antho4572/projet_SI/README.md

Ce projet a été réalisé dans le cadre du projet de terminal S-SI.
Il concerne un distributeur de nourriture  autonome pour animaux domestiques.(dossier pdf pour plus d'informations)
Retrouvez les différents modules Arduino achetés ainsi que le cablage dans le dossier "Ressources".
Vous pouvez télécharger les différentes librairies utilisées dans le programme Arduino. 

Pour toutes questions, je suis joignable par mail :
duportanthony@gmail.com
