antho4572/projet_SI/Dossier projet interdisciplinaire.pdf

## Sciences de l’ingénieur

# Projet

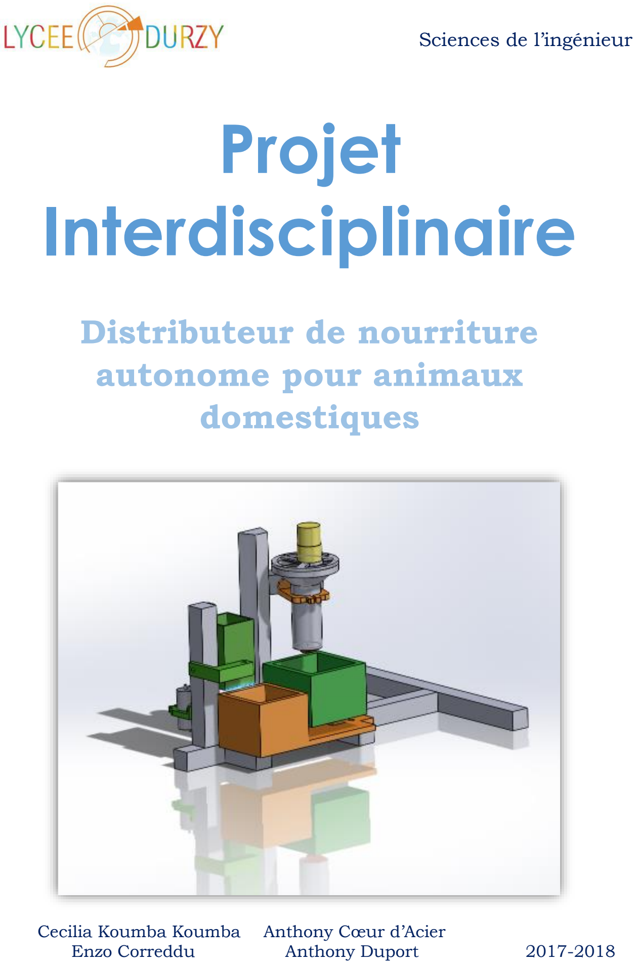
[picture p1: page 1]

Cecilia Koumba Koumba | Anthony Cœur d’Acier
Enzo Correddu | Anthony Duport | 2017-2018

# Interdisciplinaire

# Distributeur de nourriture autonome pour animaux domestiques

# Sommaire

C. PROBLEMATIQUE TECHNIQUE : COMMENT GERER AVEC PRECISION LES DOSES DE CROQUETTES ET LE VOLUME
E. DEFINITIONS DES HEURES ET DE LA PORTION DE CROQUETTES A DISTRIBUER SUIVANT LE POIDS ET LE TYPE DE

## I. Partie commune

A. Description du projet

Le contexte a été défini tel que lorsque le propriétaire de l’animal est absent, il faut nourrir l’animal dans n’importe quel endroit. De plus, il faut le nourrir à des heures définies avec des quantités de nourriture, solide et liquide, adaptées à l’animal et pouvoir communiquer avec l’appareil à distance.
Ainsi, il faudra une nourriture convenable pour un animal domestique, le chat par exemple, quand il est sans son maître durant la journée.
B. Analyse fonctionnelle
1. Expression du besoin

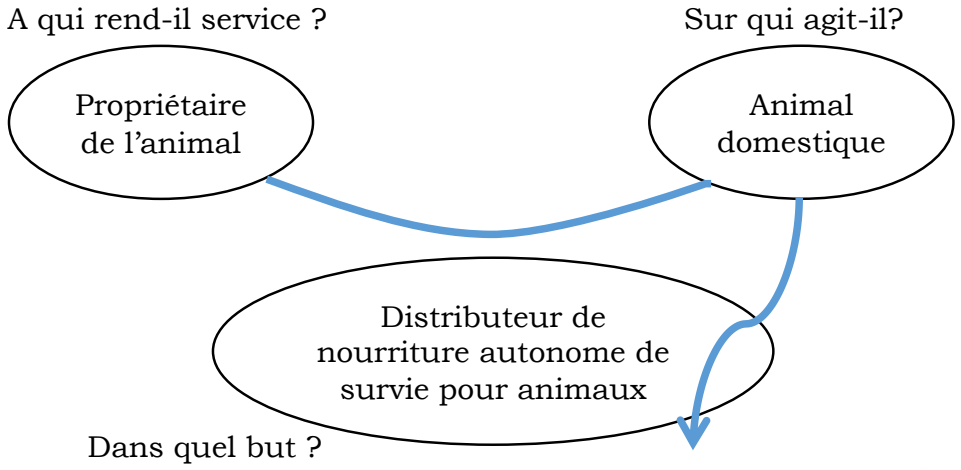
[picture p2: figure]
Propriétaire de l’animal; A qui rend-il service ?; Sur qui agit-il?; Animal domestique; Distributeur de nourriture autonome de survie pour animaux; Dans quel but ?

2. Actigramme de niveau A-0

Nourrir de façon autonome et automatisé un animal domestique

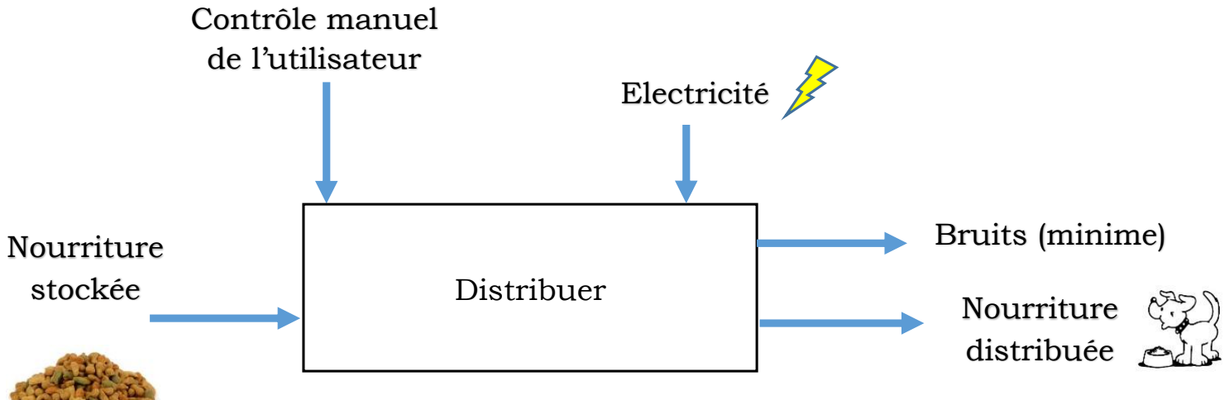
[picture p3: figure]
Contrôle manuel de l’utilisateur; Distribuer; Electricité; Nourriture distribuée; Bruits (minime) Nourriture; stockée

3. Diagramme des intéracteurs

FP1 : Distribuer l’eau et

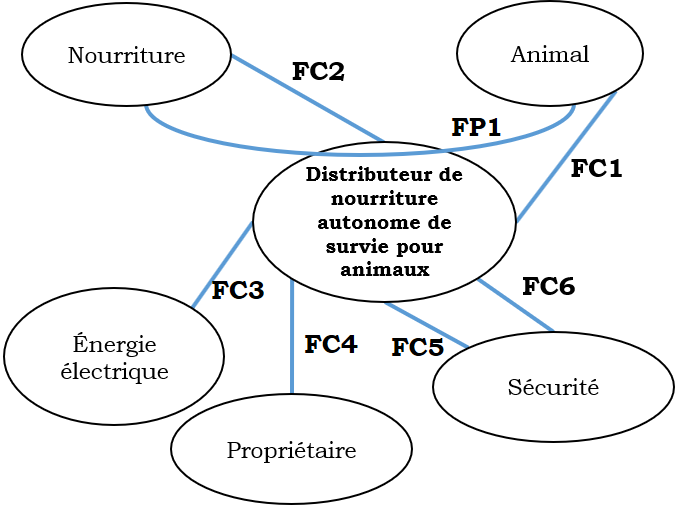
[picture p4: figure]

distribuer les croquettes à intervalles réguliers.
FC1 : S’adapter à tous types d’animaux.
FC2: Permettre un stockage suffisant de nourriture.
FC3: Avoir une autonomie
suffisante.
FC4: Etre facilement
transportable.
FC5: Permettre la sécurité de l’animal.
FC6: Etre au norme vis-à-vis de l’hygiène (croquettes).
4. Cahier des charges
- Pouvoir accepter différents types de croquettes pour animaux.
- Utiliser un récipient pour la nourriture liquide et solide et les stocker (Solide

2kg : Liquide 2L).

- Maintenir dans un réceptacle un niveau d’eau constant de

30 cl ± 3cl.

- Dose de croquette de 50 grammes par jour en trois

versements ±2g par versement.
- Être compatible avec le secteur comme source d’alimentation.
- Posséder plusieurs choix prédéfinis de réglage pour les

intervalles de nourriture.
- Être piloté par une carte électronique programmable.
- Un cycle de distribution devra durer maximum une minute.
- Durée de fonctionnement sans secteur : maximum 4 heures.
- L’ensemble devra peser maximum 10kg.
- Être facilement transportable.

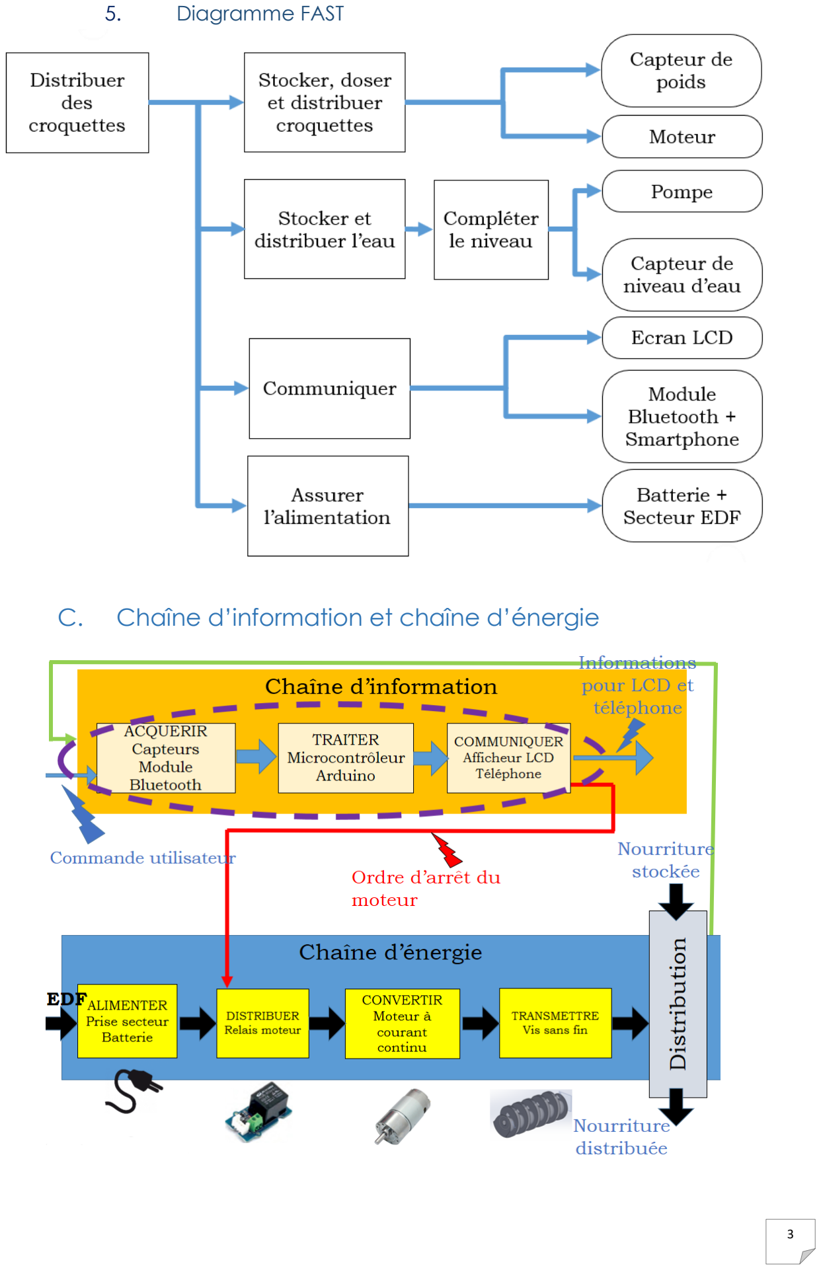
[picture p5: page 5]

5. Diagramme FAST
C. Chaîne d’information et chaîne d’énergie

D. Répartition des tâches
- Cécilia Kumba Kumba s’occupe de l’interface homme-machine via l’application sur smartphone (Android).
- Enzo Correddu s’occupe de la partie batterie avec notamment le dimensionnement de celle-ci.
- Anthony Cœur d’Acier s’occupe de la partie mécanique et de la maquette virtuelle.
- Anthony Duport, moi-même, m’occupe de la partie programmation.

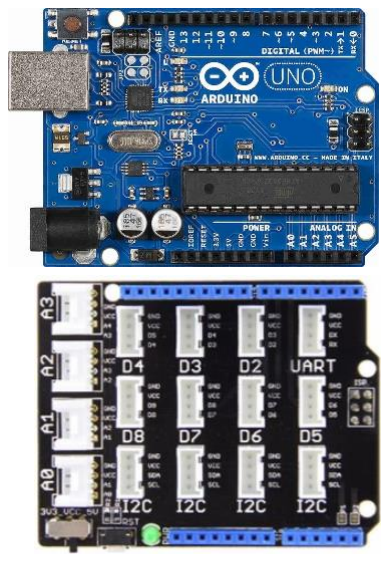
[picture p6: figure]

## II. Partie Individuel : Gérer et contrôler la distribution de nourriture

| Ma partie concerne les fonctions ACQUERIR,
TRAITER ET COMMUNIQUER de la chaîne d’information. Pour cela, j’ai choisi de programmer en ARDUINO car c’est un langage assez facile et pas compliqué à apprendre. J’ai donc dû apprendre à programmer en C donc en ARDUINO car je ne connaissais rien du tout. Pour cela, je suis allé me documenter sur internet. De plus, j’ai choisis de programmer avec des modules GROVE car c’est plus simple à raccorder à la ARDUINO et cela évite les
interférences entre fils.
A. Raccordement au module GROVE
| Pour satisfaire toutes les fonctions de notre projet, j’ai donc choisi ces
modules :

Deux modules relais pour pouvoir piloter le moteur et la pompe. (1 « pompe » et 1 « moteur »)

Un capteur de niveau d’eau pour pouvoir récupérer le niveau du réceptacle d’eau.

Un capteur de poids pour pouvoir récupérer le poids de la gamelle de croquettes.

Un module Bluetooth pour pouvoir communiquer avec le smartphone.

Une horloge en temps réel (RTC) pour savoir l’heure et pouvoir savoir quand le moteur doit se déclencher.

Un écran LCD pour pouvoir communiquer avec l’utilisateur

Deux boutons poussoirs pour pouvoir naviguer dans le menu du LCD. (1 « haut » et 1 « bas »)

Un potentiomètre pour simuler la valeur de la batterie.

Ensuite, il faut relier les composantes au module GROVE. Pour cela, on va les relier comme ci-dessous :

⸭ Le bouton poussoir « haut » sera relié sur le port D4.
⸭ Le bouton poussoir « bas » sera relié sur le port D8.
⸭ Le relais « moteur » sur le port D2.
⸭ Le relais « pompe » sur le port D3.
⸭ Le « RTC » sur un port I2C.
⸭ L’écran LCD sur un port I2C.
⸭ Le potentiomètre sur le port A0.
⸭ Le capteur de niveau d’eau sur le port A1. ⸭ Le capteur de poids sur le port A2.
⸭ Le module Bluetooth sur le port UART.

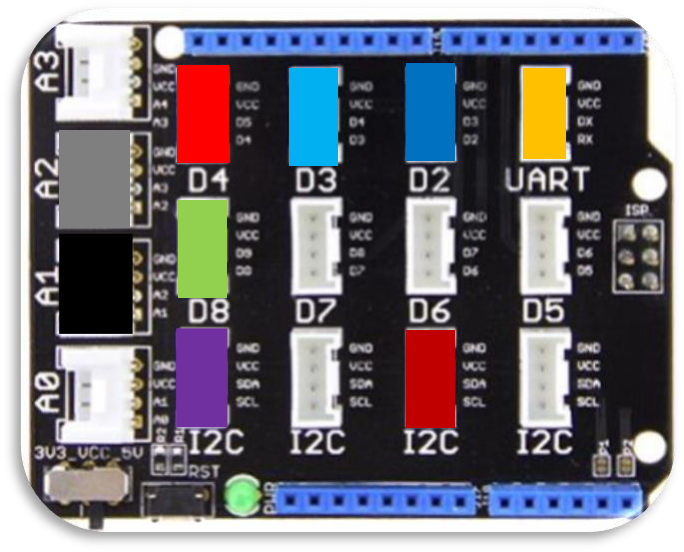
[picture p7: figure]

B. Logigramme de fonctionnement

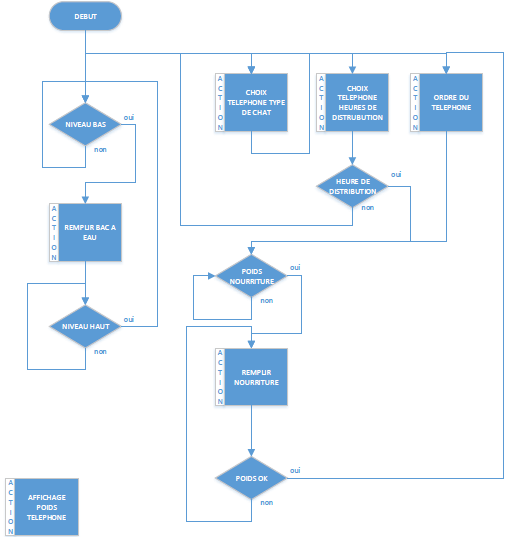
[picture p8: figure]

C. Problématique technique : Comment gérer avec précision les doses de croquettes et le volume d’eau?

Dans cette partie, nous allons nous intéresser à comment gérer avec précision les doses de croquettes et le volume d’eau? Cela se traduit par les fonctions suivantes du logigramme :

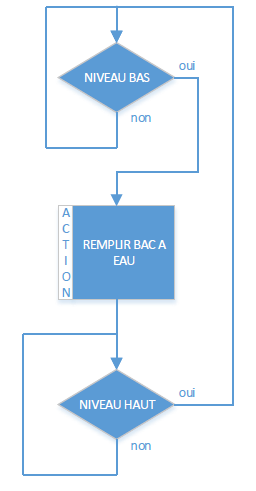
[picture p9: figure]

Remplissage de la gamelle
à eau

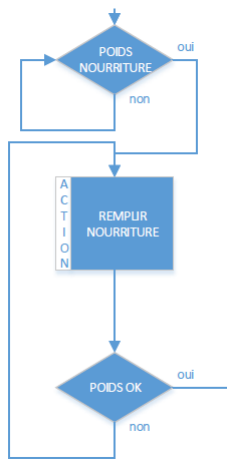
[picture p10: figure]

Remplissage de la gamelle
à croquettes

D. Programme et principe de fonctionnement
1. Pour le remplissage de l’eau :

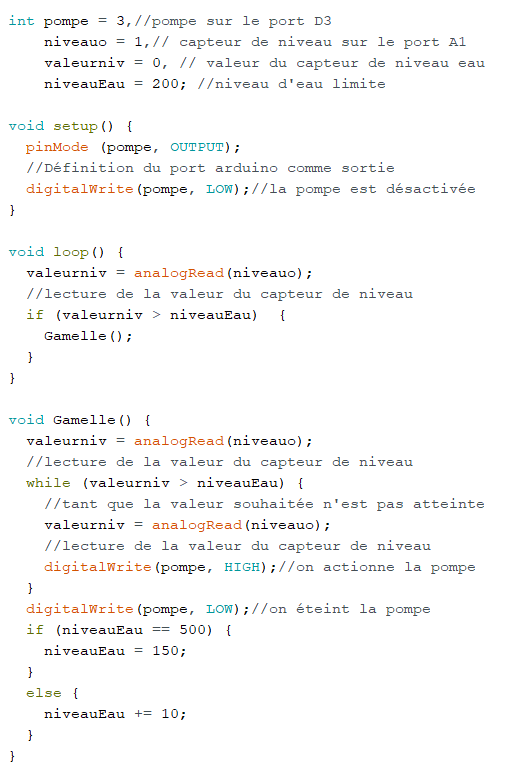
[picture p11: figure]

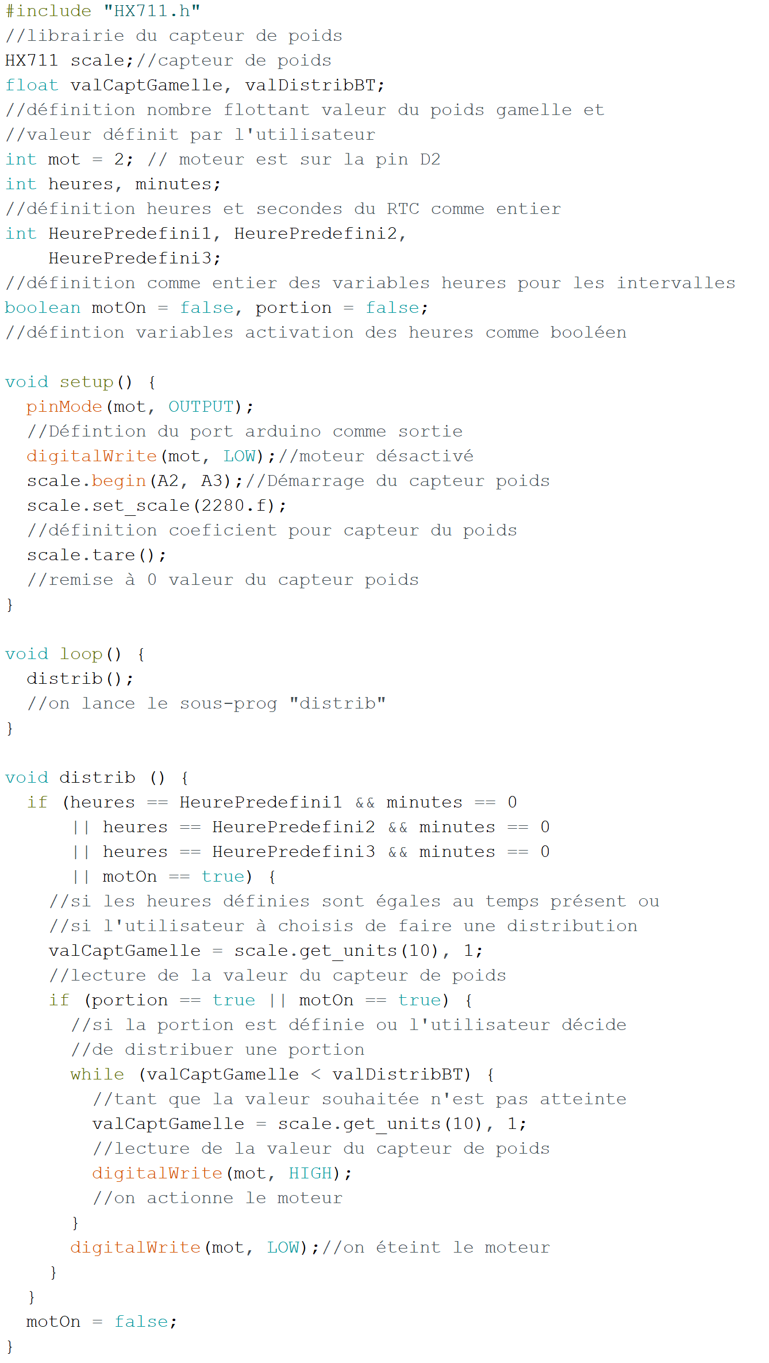
[picture p12: figure]

2. Pour la distribution des portions

3. Programme général

Pour des raisons de place et de longueur de mon programme, je ne l’ai pas mis dans mon dossier. Vous retrouvez le lien dans la dernière partie de mon dossier.

E. Définitions des heures et de la portion de croquettes à distribuer suivant le poids et le type de chats
1. Définitions des heures

Comme indiqué dans le cahier des charges, nous devons définir des heures de distribution pour les portions de croquettes.

Liste numéro | Distribution n°1 | Distribution n°2 | Distribution n°3
Liste n°1 | 6h00 | 13h00 | 18h00
Liste n°2 | 8h00 | 15h00 | 20h00
Liste n°3 | 10h00 | 17h00 | 22h00
Liste n°4 | 12h00 | 19h00 | 00h00

L’utilisateur, via l’application du smartphone, devra choisir une liste pour définir les intervalles des distributions.

2. Définition de la portion de croquettes suivant le poids et le type de chats
Poids du chat | 2kg | 3kg | 4kg
Chat d’intérieur | 100g | 150g | 200g
Chat actif | 110g | 165g | 220g
Chat stérilisé | 80g | 120g | 160g

Ensuite, il devra choisir les portions à donner par jour à son chat suivant son poids et son type. Pour l’exemple du chat d’intérieur de 2kg, il recevra 100g de croquettes par jour soit environ 33g par versement.

F. Etude des écarts
1. Entre une balance et le capteur de poids
a) Expérience

Pour savoir si le capteur de poids de notre
maquette donne une vraie valeur du poids, j’ai pesé une quantité de « croquettes » sur une balance, et elle affiche 13g (voir image ci-contre). On part du principe que la balance affiche un poids précis.

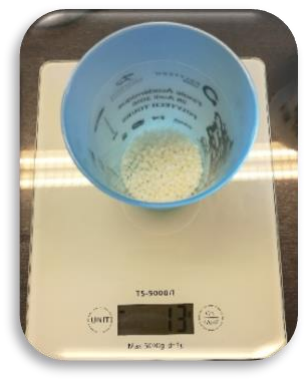
[picture p13: figure]
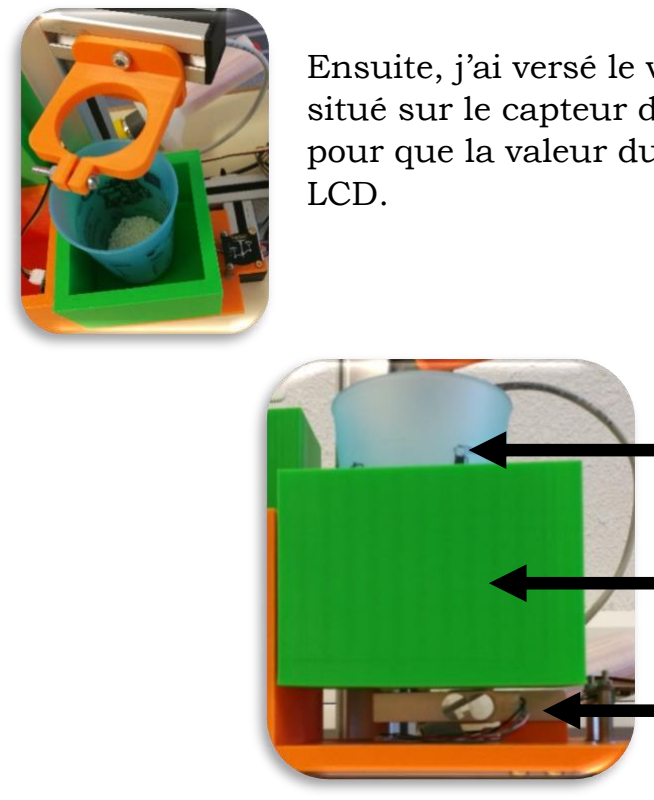
[picture p14: figure]
LCD.

Ensuite, j’ai versé le verre avec les « croquettes » dans un autre situé sur le capteur de poids. De plus, j’ai écrit un programme pour que la valeur du capteur de poids soit inscrite sur l’écran

Verre avec les « croquettes »

Gamelle pour les « croquettes »

Capteur de poids

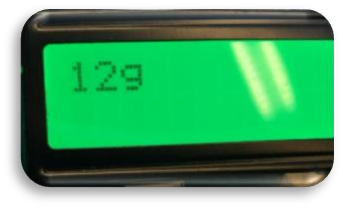
[picture p15: figure]

On peut voir que la valeur qui s’affiche sur l’écran est 12g.

b) Conclusion

La valeur affichée sur la balance est 13g et celle sur le capteur de poids est 12g.

L’écart relatif est donc :

13−12
13

### = 0.08 soit 8%

La précision du capteur est donc de 92%.

2. Le capteur de niveau d’eau
a) Expérience n°1

Le capteur de niveau d’eau fonctionne avec une résistance de 1MΩ. En fonction d’où le niveau d’eau est sur les traces du capteur, il va renvoyer une valeur entre 0 et 1024.

J’ai donc fait l’expérience de fixer mon capteur sur la paroi de la gamelle et de remplir petit à petit l’eau. Lorsque je n’ajoute plus d’eau, la valeur continue à varier alors que le niveau est stable.

b) Conclusion

On peut donc en conclure que le capteur de niveau d’eau n’est pas précis donc on ne pourra pas valider le cahier des charges qui disait qu’il fallait 15 ± 3 cl constamment dans le niveau de la gamme d’eau. Il faudrait plutôt mettre un capteur digital « tout ou rien », ce que fait aussi ce module, mais il faudra le brancher sur un port digital.

c) Expérience n°2

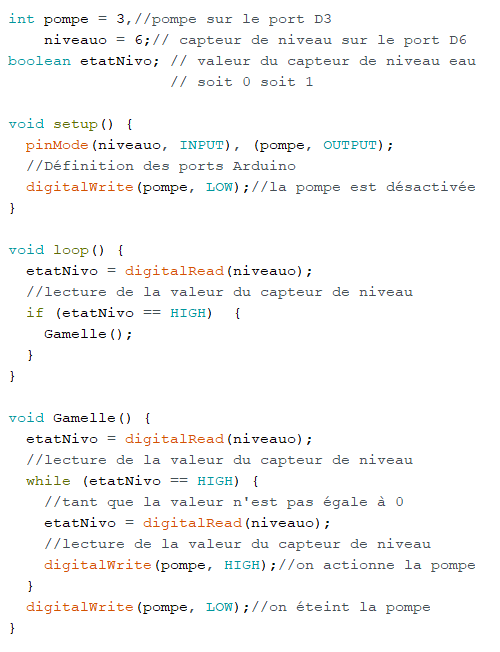
[picture p16: figure]

On branche donc notre
capteur sur le port D6.
Lorsque celui-ci sera en
contact avec l’eau, il rend une valeur « LOW » et quand il ne se pas en contact avec l’eau, il rend une valeur
« HIGH ». J’ai donc modifié mon programme pour
changer la précédente
fonction, ce qui donne :

Le capteur est donc
plus précis.

3. Mesure sur la maquette et constations des écarts
a) Mesure

Dans le cahier des charges, il est indiqué :

« Maintenir dans un réceptacle un niveau d’eau constant de 30 cl ± 3cl. »

Pour cela, j’ai mesuré les différentes valeurs de la gamelle (image ci-contre).

Ensuite, on va donc calculer le volume théorique d’eau Vt.

Vt = 8 × 8 × 4,5 = 288 cm³ Soit environ 30cl.

Ensuite, à l’aide d’une seringue, j’ai pompé l’eau contenue dans la gamelle :

- 12 Seringues de 24 ml
- 22ml
- 11ml
- 5 ml
- 8 ml

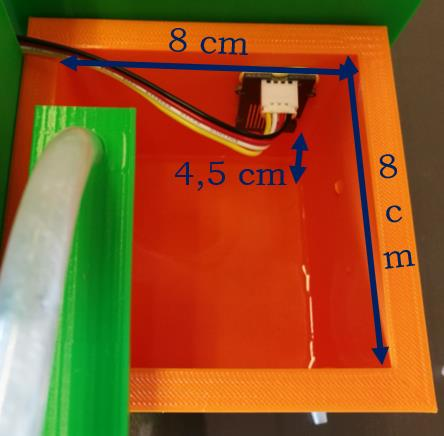
[picture p17: figure]

En additionnant ces valeurs, on obtient le volume mesuré Vm.

Vm = 12 × 24 + 22 + 11 + 5 + 8 = 334 ml Soit 33cl.

b) Constations des écarts

### Ecart relatif ∶

Vm−Vt
Vt

× 100 =

33−30
30

× 100 = 10%

L’écart relatif est donc de 10% et le cahier des charges est validé car la valeur mesuré est 33 cl et il autorise entre 27 et 33 cl.

III. | Conclusion du projet
| Pour conclure, ce projet m’a permis de découvrir
l’environnement Arduino avec ses différents modules ainsi que le langage de programmation qui parfois peut être complexe. De plus, j’ai développé ma curiosité, et j’ai été confronté à des problèmes comme par exemple lorsque j’écrivais un code qui me semblait bon et que le résultat n’était pas le même que celui que j’attendais.

## IV. Diffusion du projet

Retrouvez le programme en entier ainsi que l’application et les différents documents sur ce lien :

- https://github.com/antho4572/projet_SI

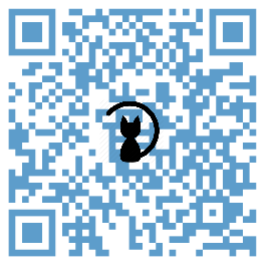
[picture p18: figure]
